mpbrucker/PoEJukeboxHeroes/docs/index.md

---
layout: default
title: Home
description: Five people. One Jukebox. Who will survive?
---
# This is a dummy page.
