mpbrucker/PoEJukeboxHeroes/docs/hardware.md

---
layout: no-sidebar
title: Mechanical Subsystem
description: The hardware under the hood of our mechanical jukebox.
category: subsystem
---

Within our jukebox, there are three mechanical subsystems: the enclosure, the marble chutes, and the marble return. The enclosure looks like a jukebox, and integrates all mechanical and electrical subsystems. The marble chutes allow the solenoids to accurately drop one marble at a time onto the corresponding xylophone note below. The marble return carries the marbles from the bottom of the enclosure to the top.  

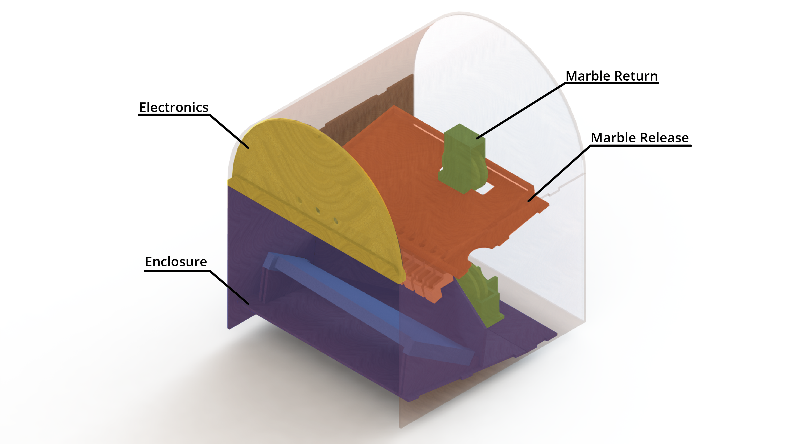
[picture p1: docs/images/Subsystems.png]


*Our final jukebox design, as shown in CAD. This diagram shows how all the mechanical subsystems interface with each other, as well as with the front plate on which the electronics are mounted.*

Learn more about each of the components of our mechanical design:

[Marble release]({{site.baseurl}}/chutes.html) - the chutes and solenoids that actually play the notes.

[Marble return]({{site.baseurl}}/marble_return.html) - our system to return marbles to their original place.

[Enclosure]({{site.baseurl}}/enclosure.html) - what holds everything together.

[Aesthetics]({{site.baseurl}}/aesthetics.html) - how we made everything look nice.
