mpbrucker/PoEJukeboxHeroes/docs/chutes.md

---
layout: no-sidebar
title: Marble Release Mechanism
description: The release mechanism that actually drops the marbles.
type: subpage
---

The task of releasing one marble at a time was not a trivial one. Almost everyone in the group had a turn with it and the system went through about 20 redesigns before a successful ramp was made. The main feature that proved this mechanism’s challenge was consistency of singular release. In order to do this, we decided to use a solenoid that activates through a hole in the ramp. With this in mind, we iterated and iterated until the shape of the ramp was finished.  

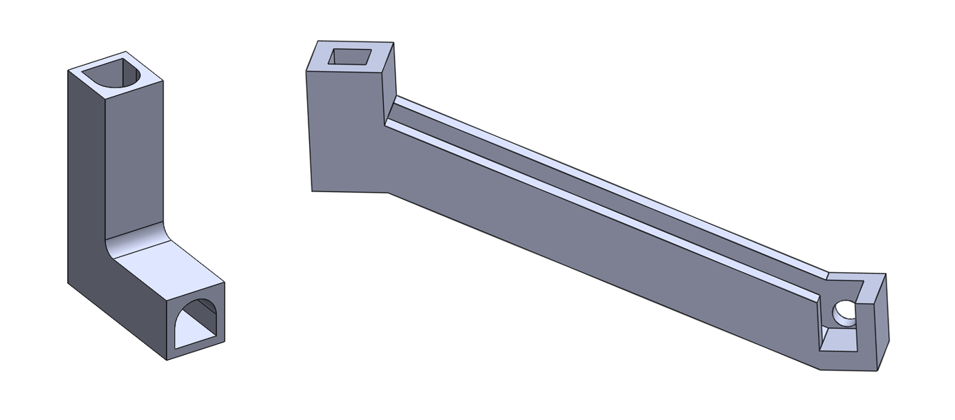
[picture p3: docs/images/bothtogether.PNG]
The L and long chute designs.


The initial two ramp designs were the "L" and the long ramp, shown above. The "L" lined up the marbles vertically and the solenoid was activated from the back side. The long ramp assembled the marbles in a shallower slope that flowed downwards to the right, with the solenoid still mounted to the back. When tested, both designs proved to be wildly unpredictable. Gradually, the ramp became a channel that lines the marbles up in a slope that deposits them directly forward from the above channels, as illustrated below. This allowed for consolidation of space as well as a cleaner design.  

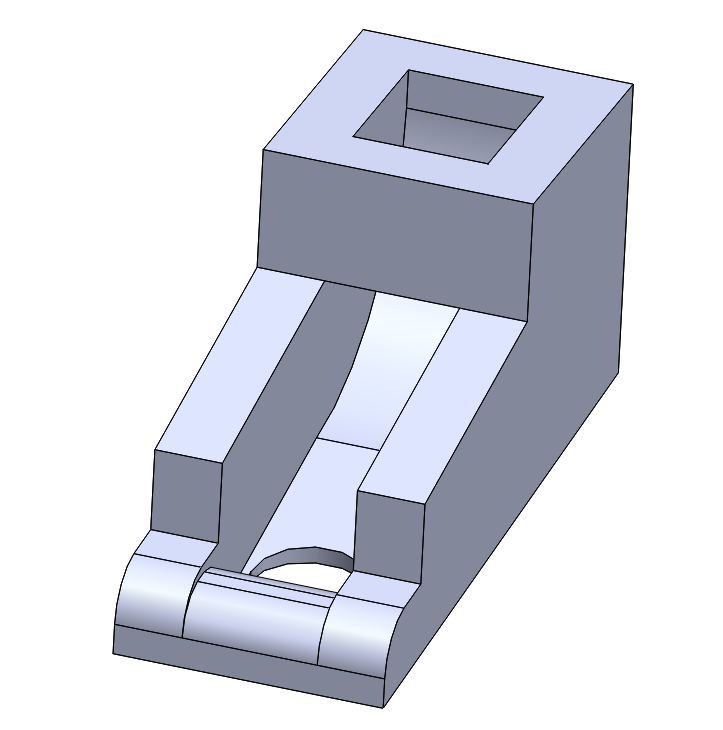
[picture p4: docs/images/rampwosol.png]
The final ramp design.


The most important aspect of the final ramp design was the manipulation of the solenoid’s angled position. While the ramp itself proved to be a well-engineered device, it alone did not determine whether the marble release was consistent. If the angle of the solenoid was changed, all while using the same ramp, the mechanism could release anywhere from one marble to five.  

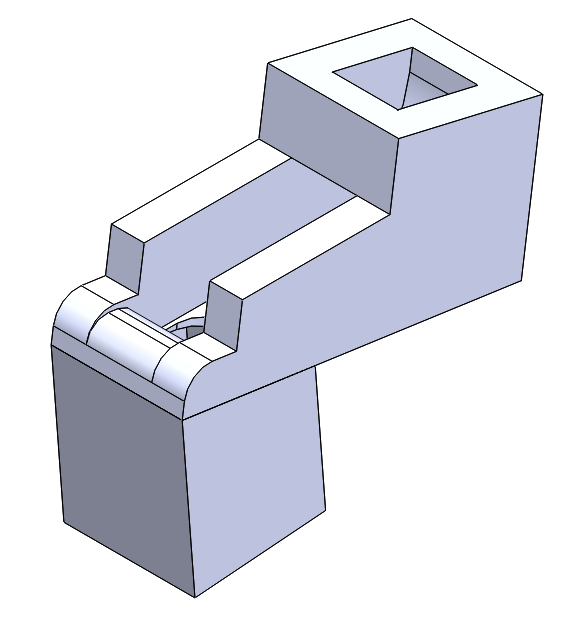
[picture p5: docs/images/final_chute_and_holder.png]
The ramp and solenoid holder assembly.


At first, when we believed that the ramp alone would ensure consistency, the solenoids were attached with hot glue. While trying to determine whether the rest position of the solenoid would be extended or retracted, the solenoids would heat up and fall off if left retracted for too long. Thus, we designed a holder that angled the solenoids towards the front of the ramp, featured above, giving just enough length at full extension to push the marbles over the small hump.

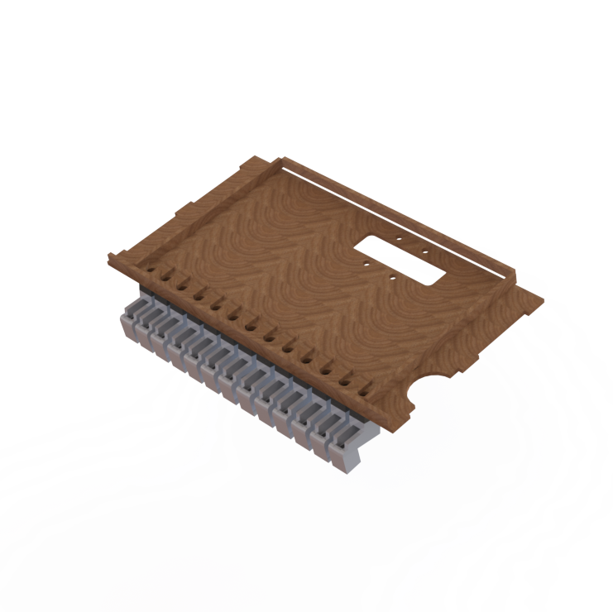
[picture p6: docs/images/MarbleChutes.png]


The thirteen chute assemblies are attached to the marble holder ramp, as shown above. The marble holder has channels in it designed to only allow one marble into the chute at a time, with rounded ends to prevent two marbles from getting stuck in the channel - we encountered many issues with marbles getting stuck in the chute openings, so we had to narrow the chute width and add the rounded ends to help.
