mpbrucker/PoEJukeboxHeroes/docs/assets/css/images/background2.jpg

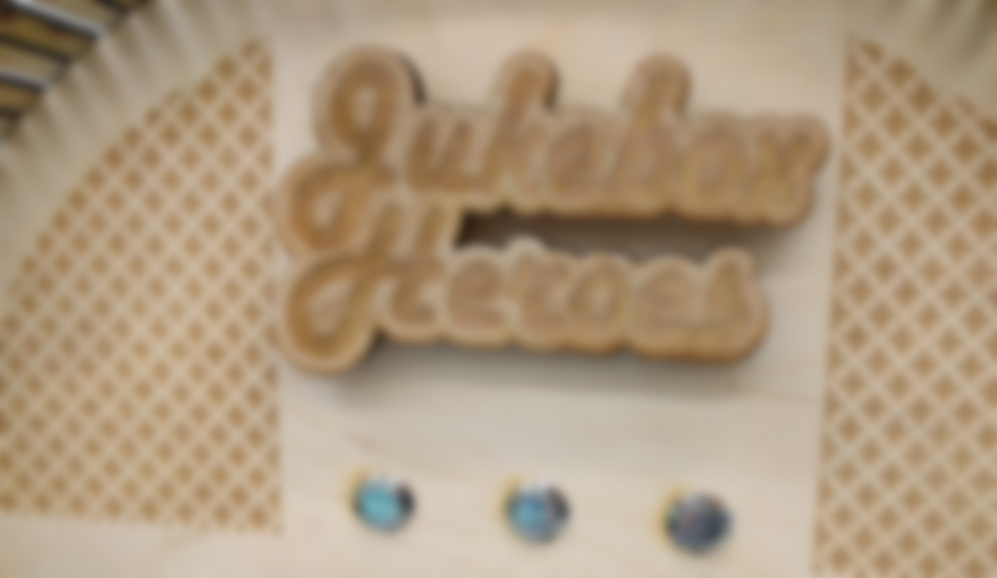
docs/assets/css/images/background2.jpg
