mpbrucker/PoEJukeboxHeroes/docs/assets/css/images/background.jpg

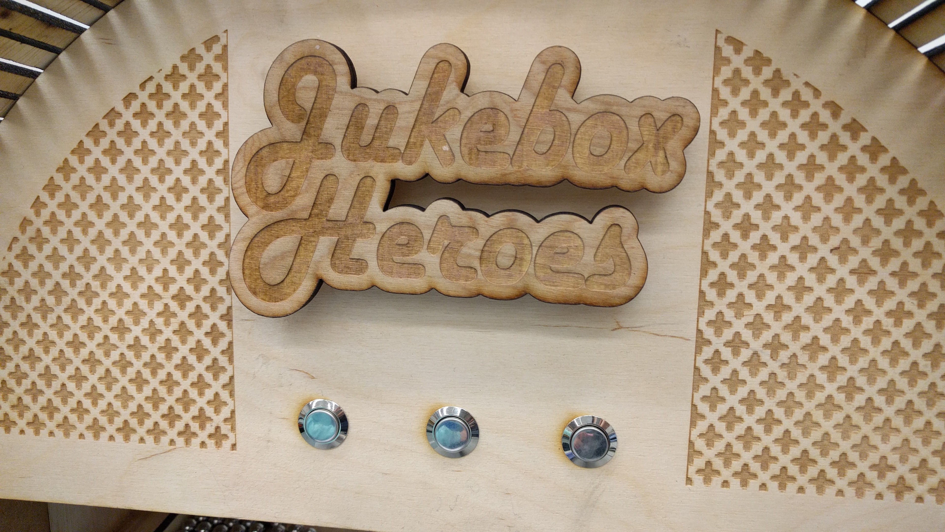
docs/assets/css/images/background.jpg
