mpbrucker/PoEJukeboxHeroes/docs/images/about_us.jpg

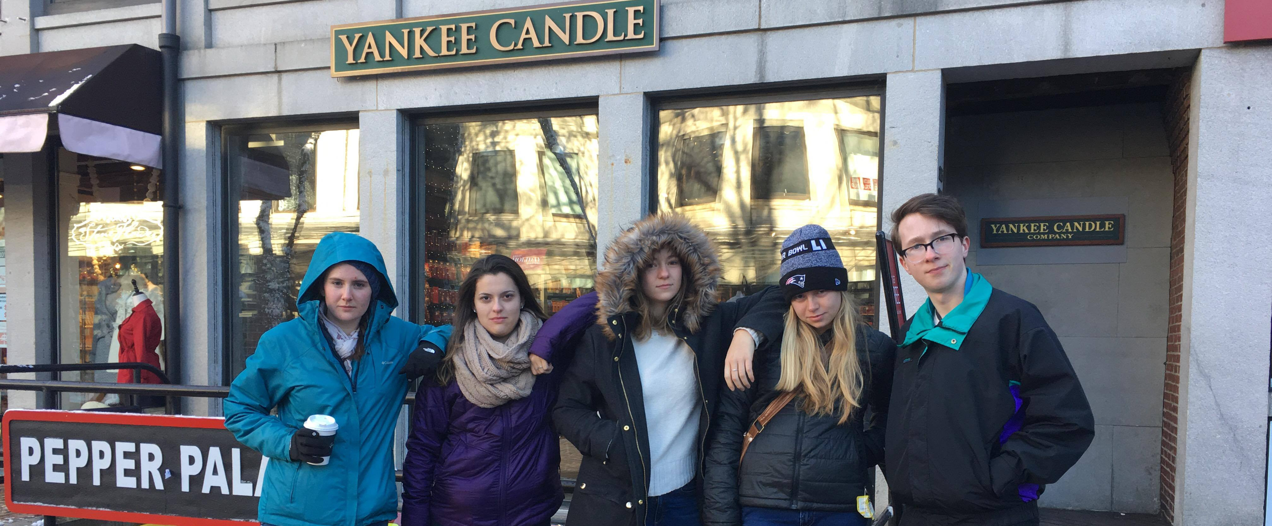
docs/images/about_us.jpg
