mpbrucker/PoEJukeboxHeroes/docs/images/aesthetics.jpg

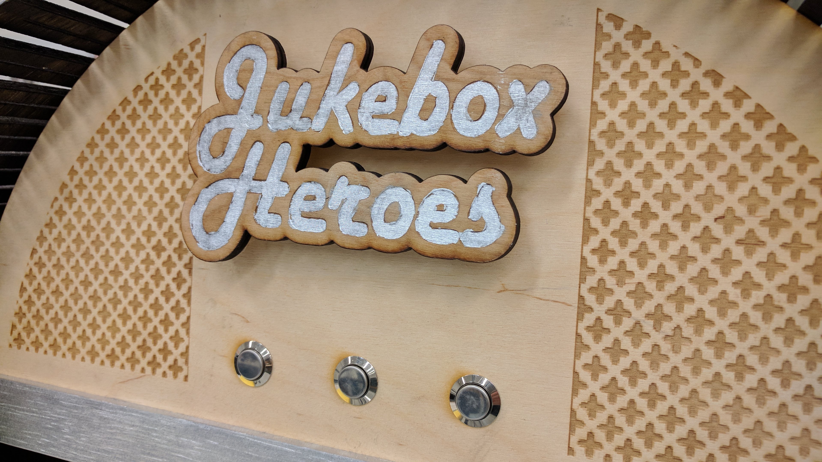
docs/images/aesthetics.jpg
