mpbrucker/PoEJukeboxHeroes/docs/images/Budget-orig.jpg

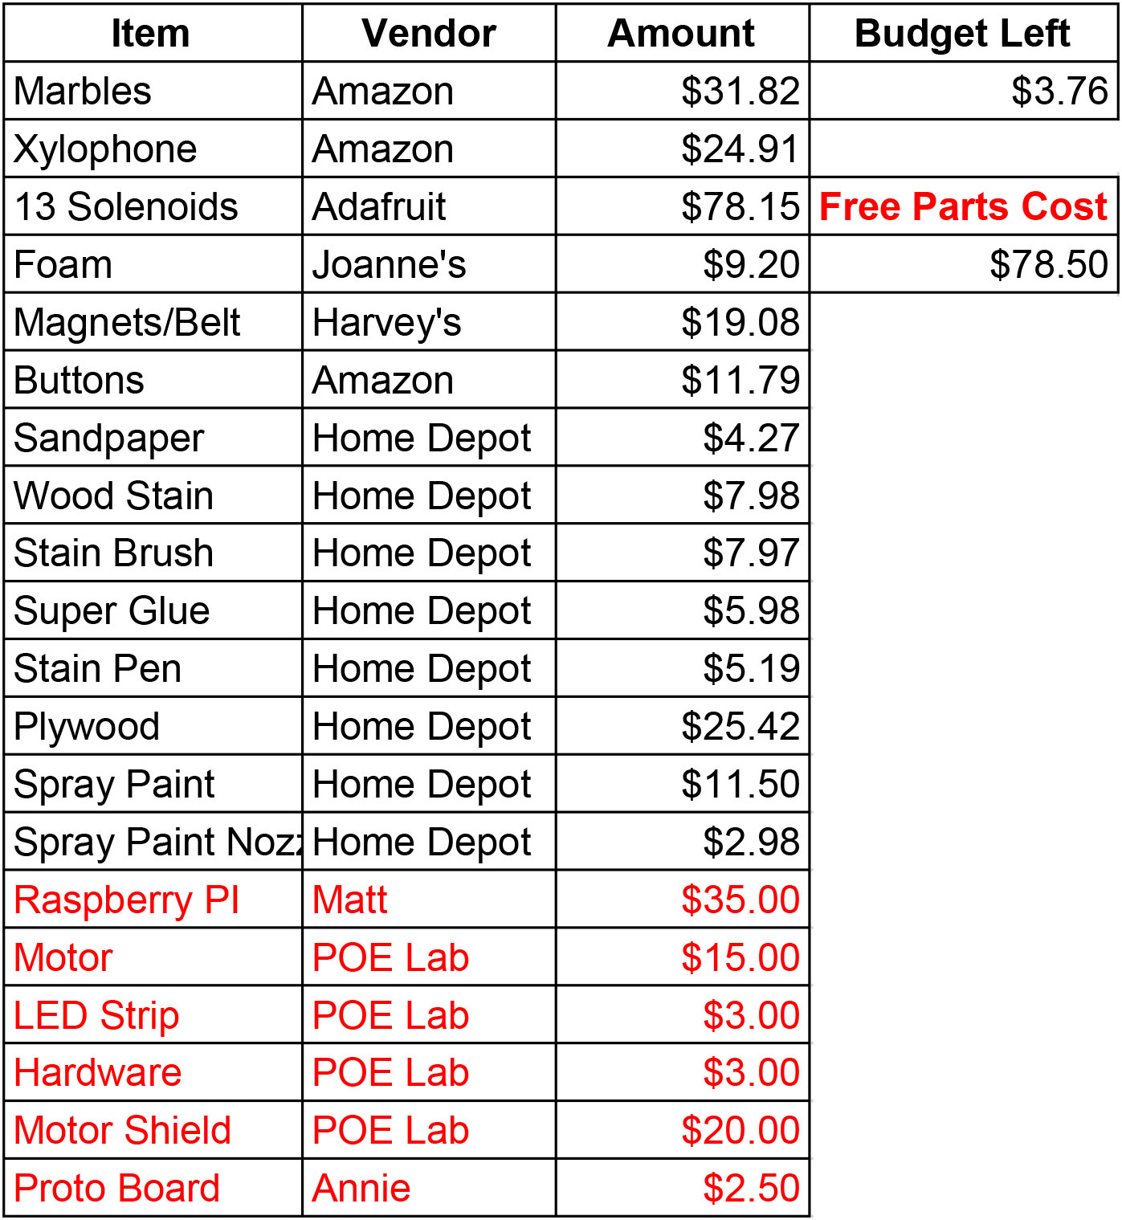
docs/images/Budget-orig.jpg
