mpbrucker/PoEJukeboxHeroes/docs/images/budget.jpg

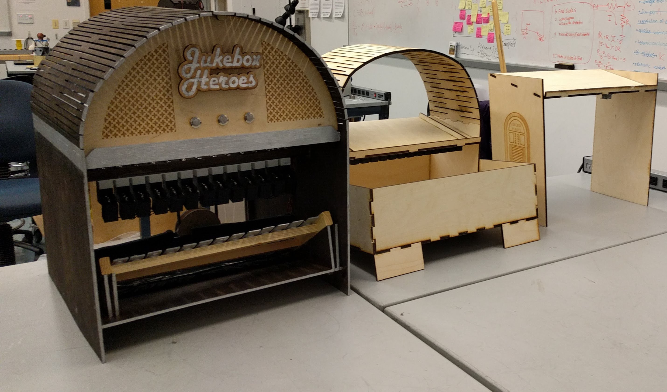
docs/images/budget.jpg
