mpbrucker/PoEJukeboxHeroes/docs/images/chutes.jpg

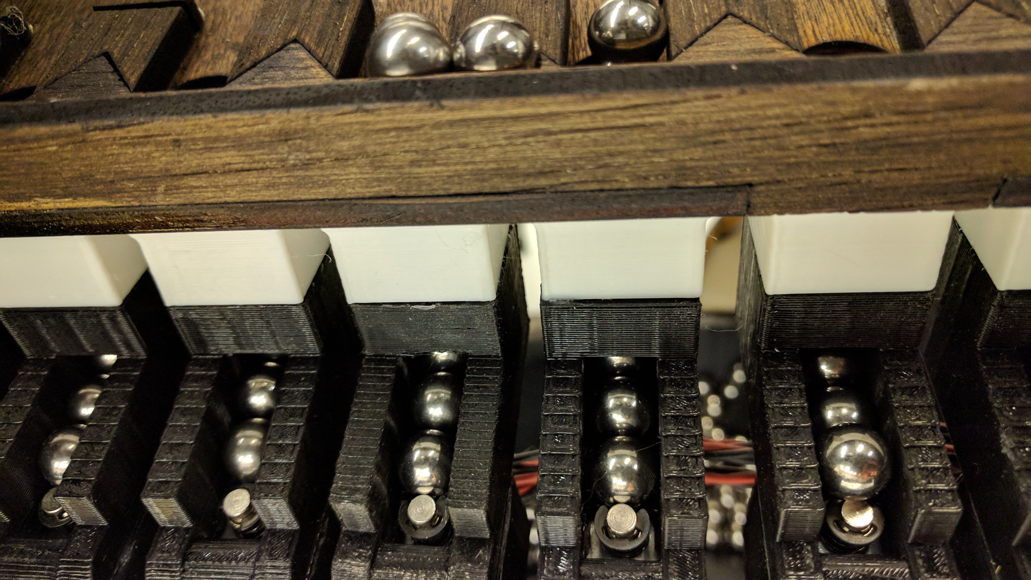
docs/images/chutes.jpg
