mpbrucker/PoEJukeboxHeroes/docs/images/electricals.jpg

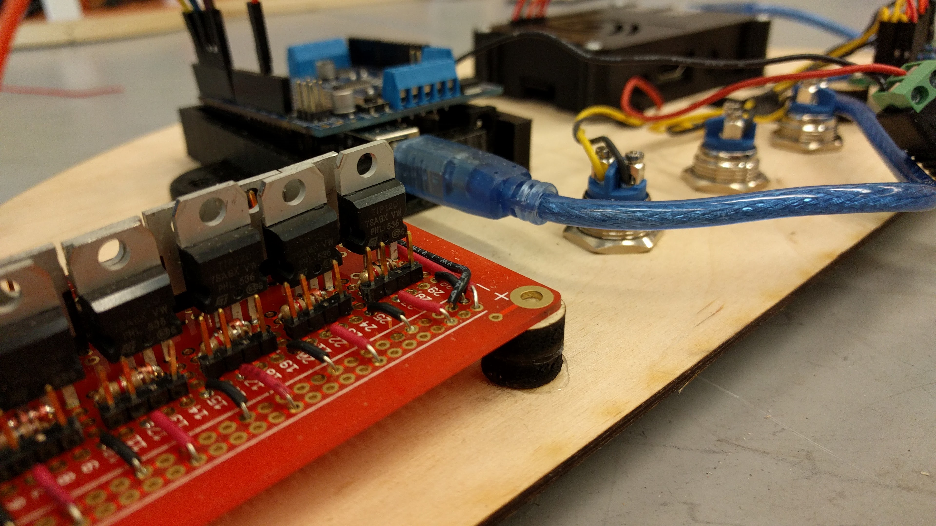
docs/images/electricals.jpg
