mpbrucker/PoEJukeboxHeroes/docs/images/enclosure.jpg

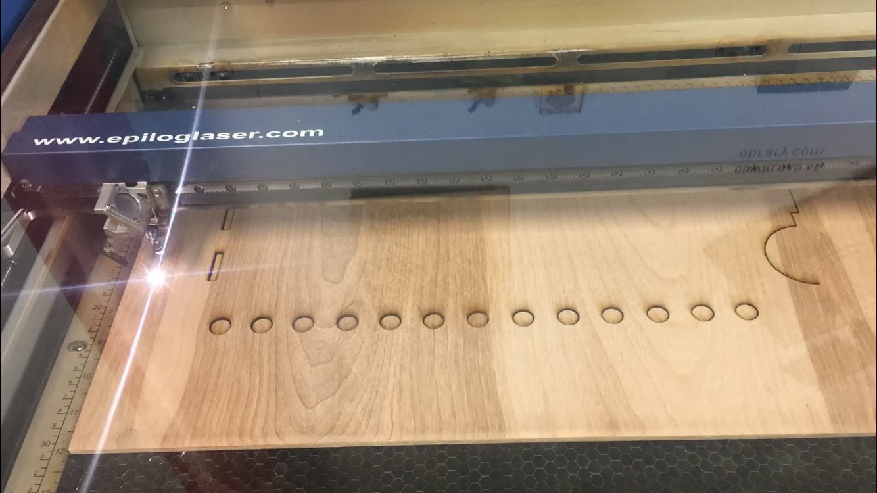
docs/images/enclosure.jpg
