mpbrucker/PoEJukeboxHeroes/docs/images/FinalRender2.png

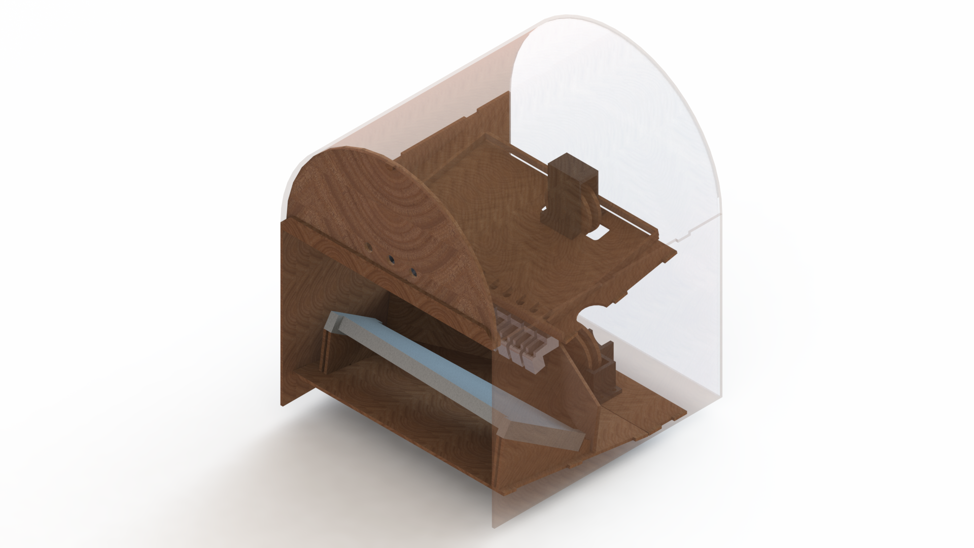
docs/images/FinalRender2.png
