mpbrucker/PoEJukeboxHeroes/docs/images/full_timeline.png

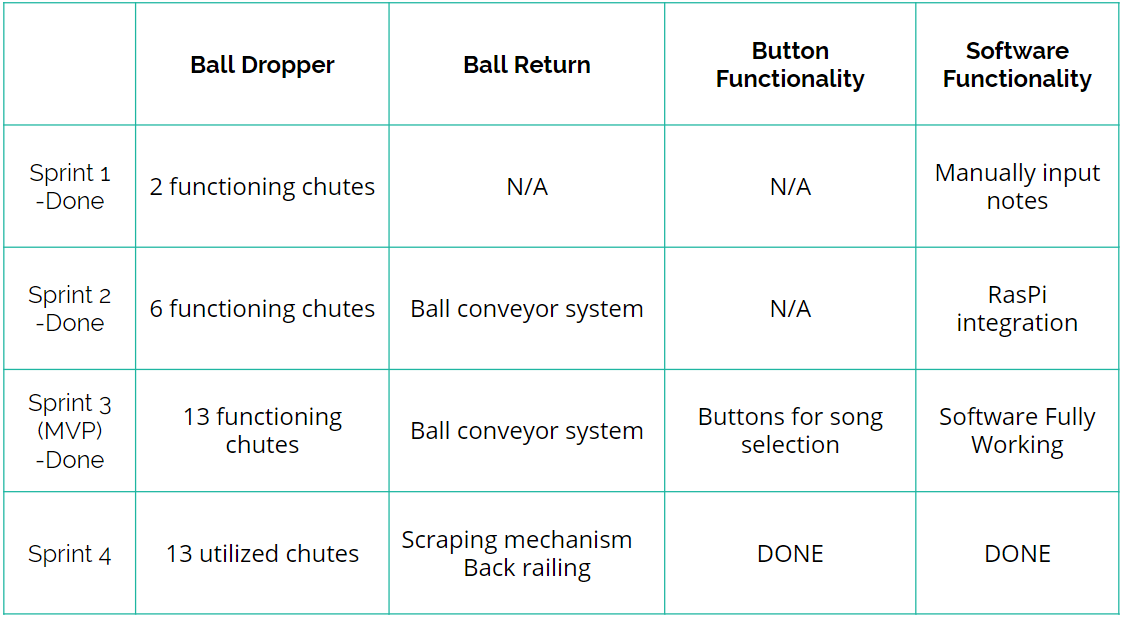
docs/images/full_timeline.png
