mpbrucker/PoEJukeboxHeroes/docs/images/hardware.jpg

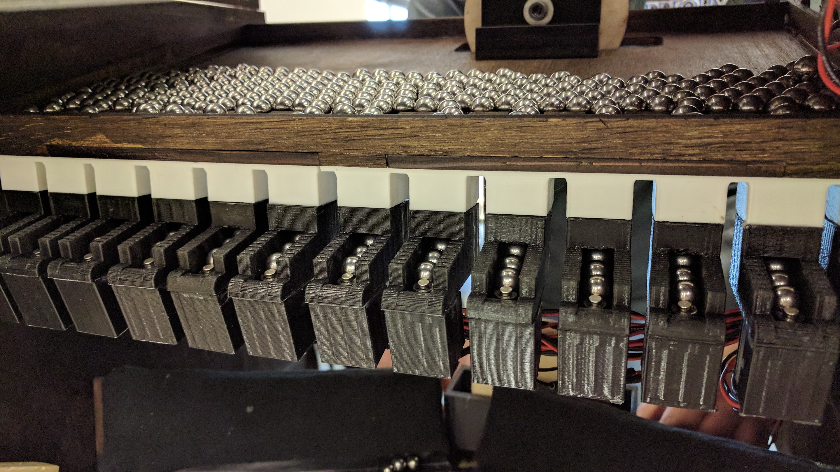
docs/images/hardware.jpg
