mpbrucker/PoEJukeboxHeroes/docs/images/longchute.PNG

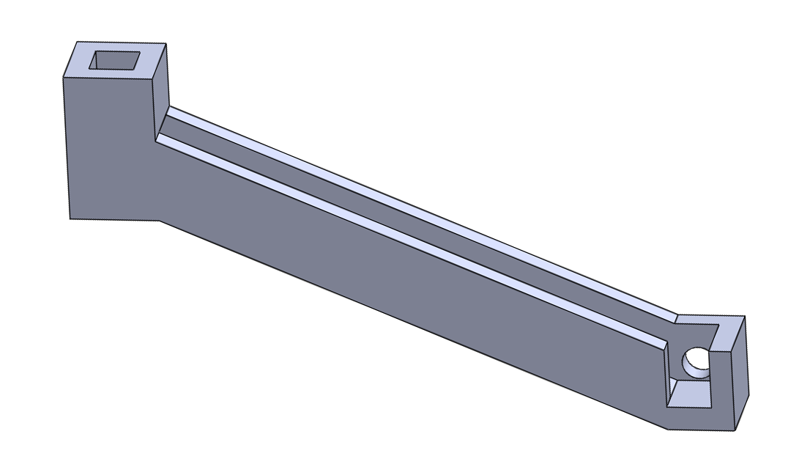
docs/images/longchute.PNG
