mpbrucker/PoEJukeboxHeroes/docs/images/marble_return.jpg

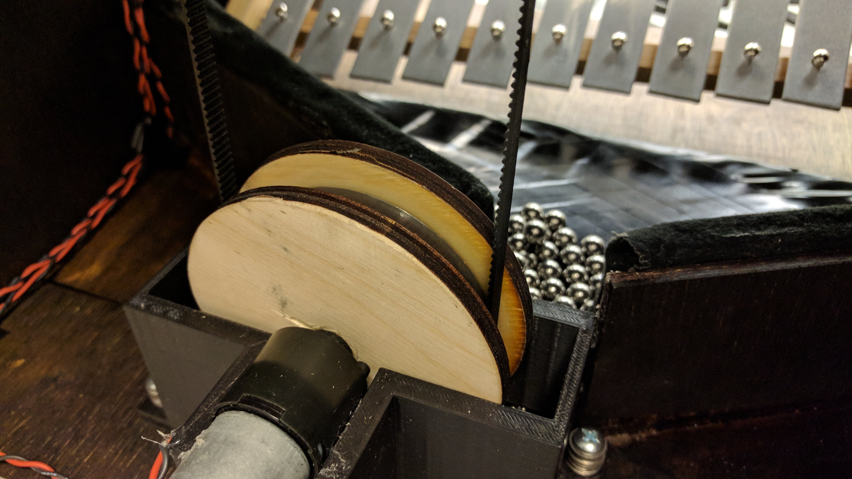
docs/images/marble_return.jpg
