mpbrucker/PoEJukeboxHeroes/docs/images/Name plate.JPG

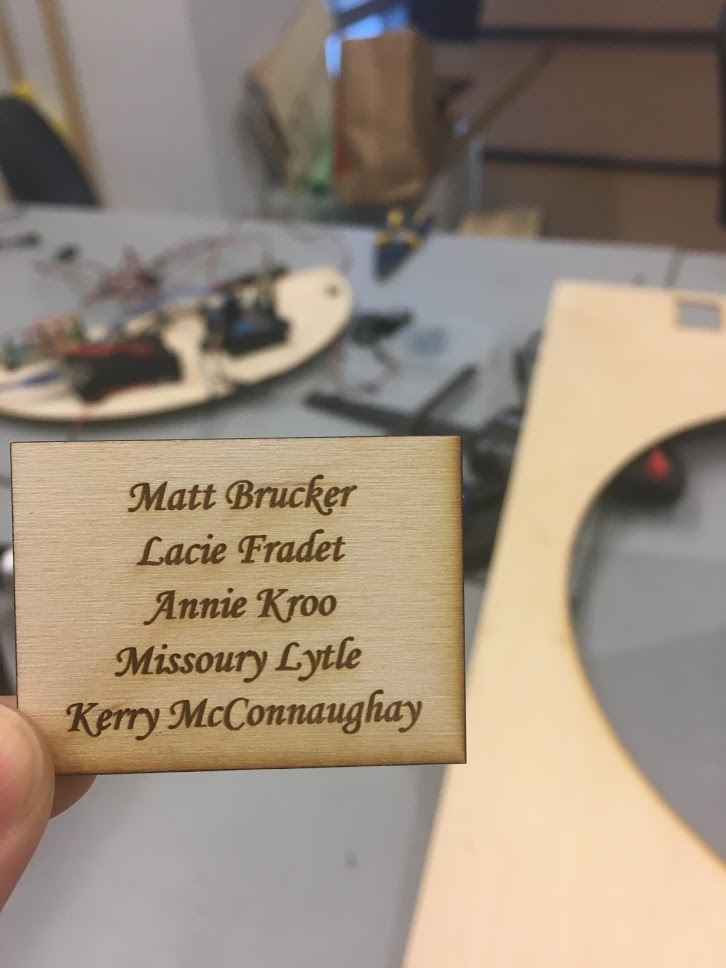
docs/images/Name plate.JPG
