mpbrucker/PoEJukeboxHeroes/docs/images/software.jpg

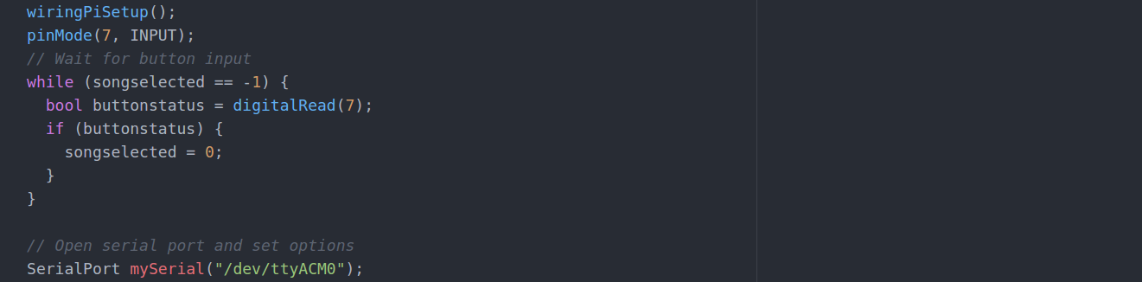
docs/images/software.jpg
