mpbrucker/PoEJukeboxHeroes/docs/images/sprints.jpg

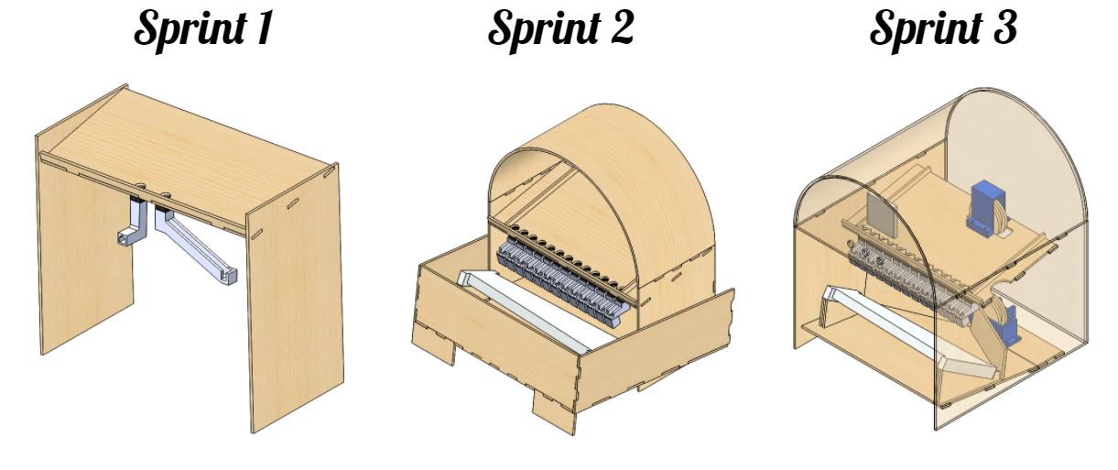
docs/images/sprints.jpg
