mpbrucker/PoEJukeboxHeroes/docs/images/SystemDiagram.png

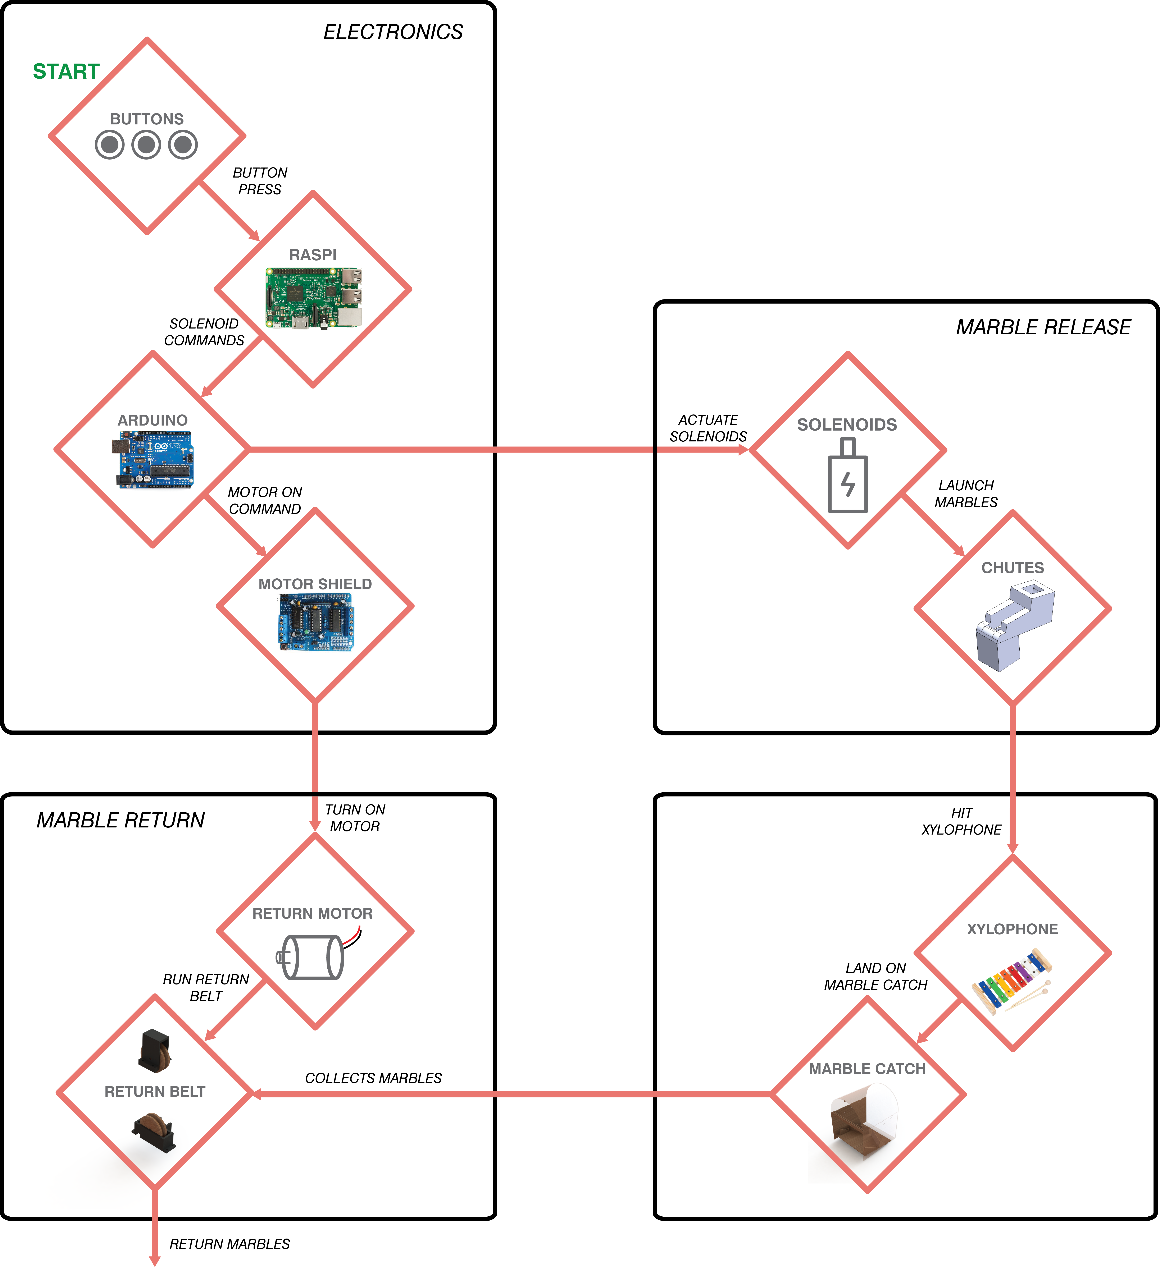
docs/images/SystemDiagram.png
