mpbrucker/PoEJukeboxHeroes/docs/images/theL.PNG

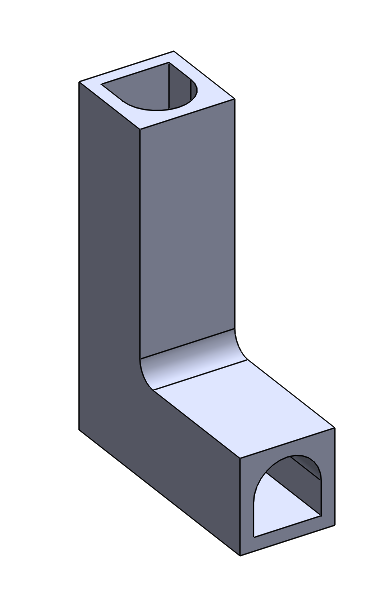
docs/images/theL.PNG
