mpbrucker/PoEJukeboxHeroes/docs/images/timeline.jpg

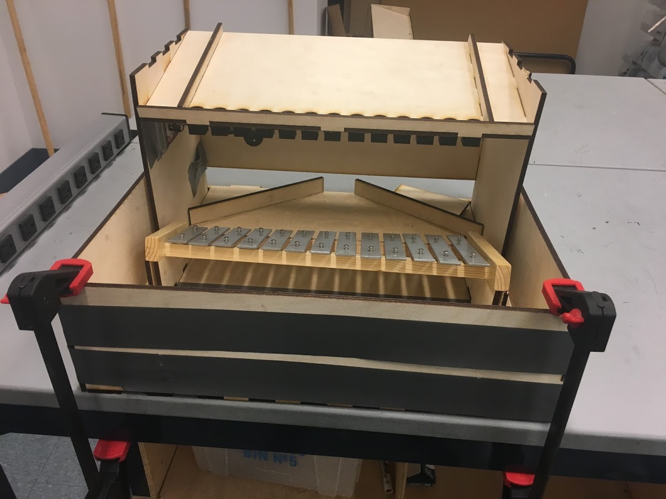
docs/images/timeline.jpg
