mpbrucker/PoEJukeboxHeroes/(commit log)

2017-10-15 Adding initial Arduino code.
2017-10-21 Added functioning serial processing code that doesn't use delays.
    [PlayNotes.ino]
2017-10-30 modifying Arduino code.
2017-11-04 Added new pin selection method.
2017-11-16 Made button press detection work using WiringPi.
2017-11-25 adding circuit diagram
2017-12-01 Fixing multiple song selection.
    [ParseMIDI.cpp]
2017-12-05 Updating so songs can be played multiple times, and changed output pins on Arduino.
2017-12-07 Updated with enclosure subsystem and overview
2017-12-10 Updating process and circuits images.
2017-12-11 Update electricals.md
    fixing solenoid description to clarify timeline
2017-12-11 Fixing enclosure image.
2017-12-12 Fixing more things and adding system schematic.
2017-12-14 adding final circuit diagram
2017-12-14 adding final circuit diagram photoshopped
